larus-breeze/hw_sensor/README.md

# PCB design for Larus Sensor 

## Facts
- STM32F407 for signal processing 
- U-Blocks M9N GNSS
- xSense MTi1 IMU
- MS5611 static pressure sensing
- HSCMRRV001PG2A3 pitot pressure sensing
- Micro-SD for logging
- ESP32 for Bluetooth and Wifi Connectivity
- CAN Bus via RJ45
- RS232 via RJ45
- USB connectors for STM32, ESP32, GNSS

## Assembled sensor V2.0

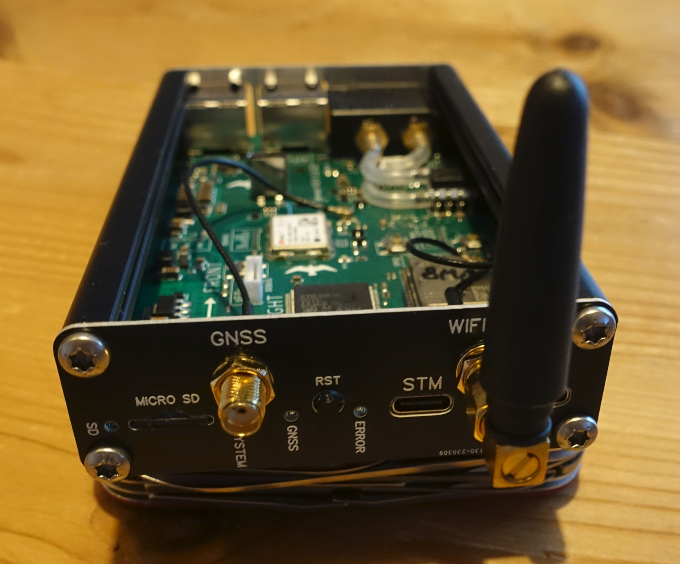
[picture p1: media/v2_full_assembled_front.jpg]


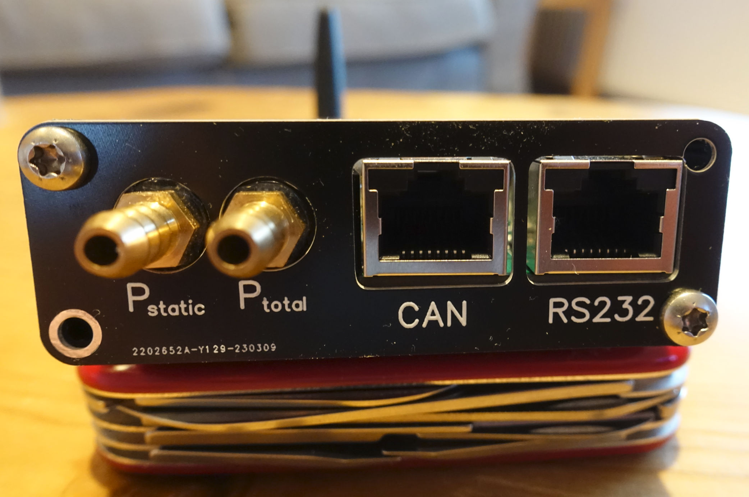
[picture p2: media/v2_full_assembled_back.jpg]


## PCB design V2.0

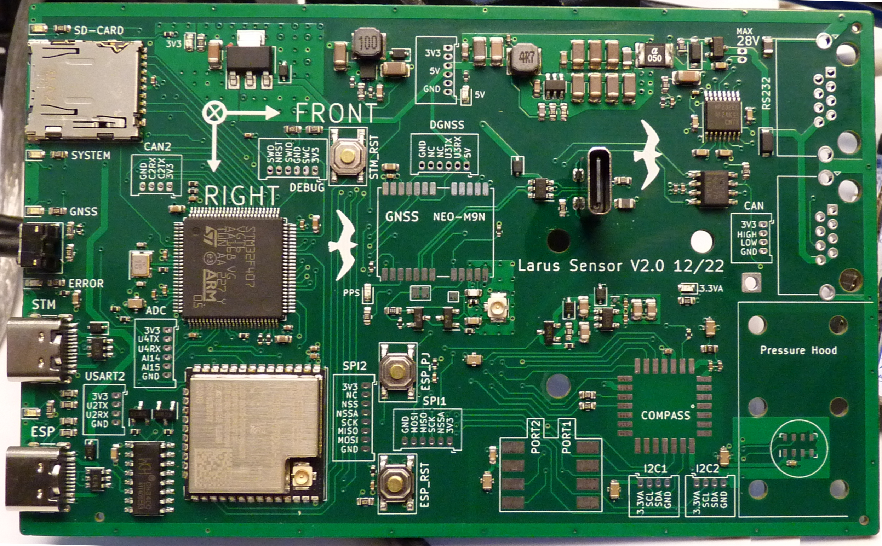
[picture p3: media/v2_soldered_components.jpg]
Components Soldered Model


## Assembled sensor V1.0
Static and pitot pressure shall be connected using 5mm inner diameter houses which are typical in a glider

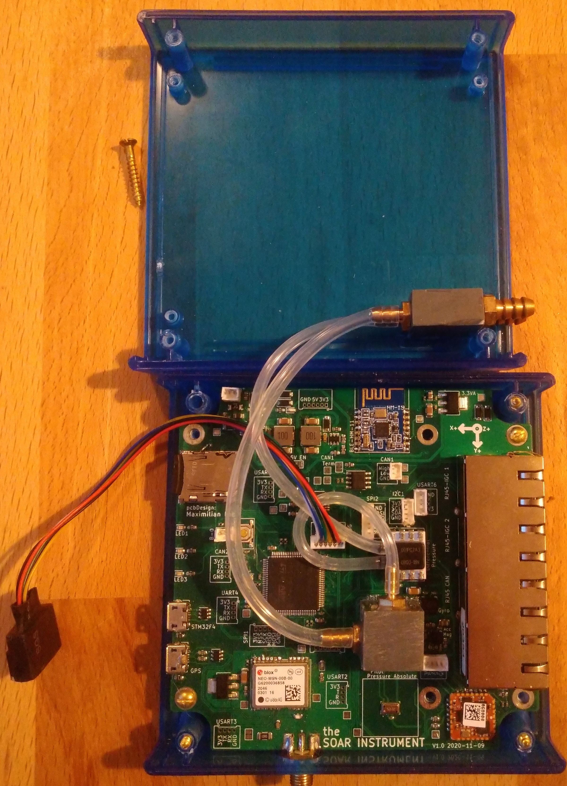
[picture p4: media/v1_full_assembled_1.jpg]
Assembled 1


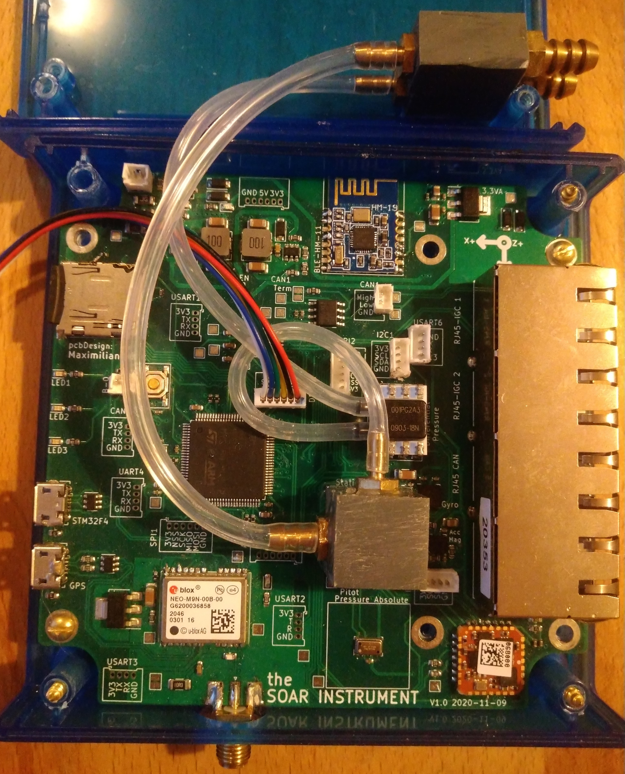
[picture p5: media/v1_full_assembled_2.jpg]
Assembled 2


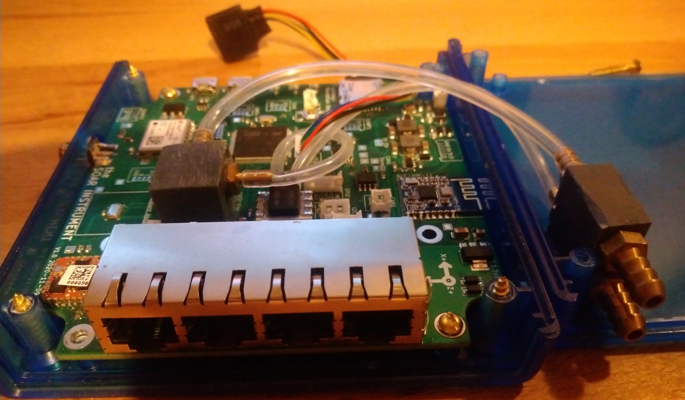
[picture p6: media/v1_full_assembled_3.jpg]
Assembled 3
