larus-breeze/hw_sensor/design/README.md

# PCB design for Sensor V2.0 

## Current consumption consideration
### Measured consumption of hw version 1.0
- M9N GNSS active, SD-card logging active, Bluetooth connected, 
- 1.071W 85mA Peak at 12.6V supply. ~ 320mA at 3.3V
- 50mA HM-19 Bluetooth

### Maximum estimation 3.3V Line for hw version 2.0
- 102mA max @85°C STM32F407 
- 200mA max peak Micro SD
- 100mA peak max M9N GNSS
- 130 - 310mA ESP32 (70mA CPU + 240mA Wifi full power or 60mA bluetooth connected) 
- 33mA xSense MTi1 IMU
- 1.4mA peak MS5611
- 2.8mA peak HSCMRRV001PG2A3 absolute pressure sensing
- 1mA (60mA short circuit output current) RS232 Converter
- 60mA "Dominant- High Bus Load"  180mA "Dominant- Bus Fault" CAN Transceiver
Total:  810.2mA max total. 

## Mechanical design:

### Enclosure
- Hammond Electronics 1455K1202 Enclosure 75x 120mm  PCB 74.6 x 120
- Free Space (active area on PCB) in enclosure 70 x 120  with some margin 69 x 120 mm 

### PVC milled 5mm Hose preassure connector
- 30mm(long) x 20mm(wide) x ~ 15 .. 20mm( high) 
- 1 x MS5611 underneath 
- 6 x 2.5mm screw connection to PCB. 

## ESP32 for WIfi / BT connectivity
- GPIO16 / GPIO17 on ESP32 connected with USART2 (PA2/PA3) at 38400 baud. Flashed https://github.com/AlphaLima/ESP32-Serial-Bridge   Prototype works. Connection of two Android Smartphones with each two connenctions to a TCP socket worked. 
- Connect GPIO04 / GPIO15 on ESP with USART1 (PA9/PA10), Connect STM32F4 Reset and Boot0. 
- Add some headers for the other esp32 connectors.
- Add a reset and program (GPIO0) button. Connect GPIO1/GPIO3 via CH340E to a USB connector.
- Connect a SPI data pump between ESP(Slave VSPI) and STM32(Master SPI2).  
Use ESP Pins: VSPI (CS:  5, CLK: 18, MOSI: 23, MISO: 19)  https://github.com/hideakitai/ESP32DMASPI  
Use STM32 Pins: CS: PB12, CLK: PB13, MOSI: PB15, MISO: PB14 ( Reuse L3GD20 interface, but provide another CS on the connector (PB0 or PB1) in case an external IMU needs SPI2)

- Where to connect the external RS232 interfaces?  XCSOAR via Wifi should be able to put data on the external RS232 line.  
- Should an external device be able to talk to the STM32F4 directly or is it sufficient to connect these inputs only to the ESP32?
- STM32F4 RS232: USART1, USART2   
- STM32F4 BT: USART6

ESP32 Pins
USART0:  GPIO1, GPIO3   (Debug & Flash UART)
USART1:  GPIO15(RX), GPIO04(TX)
USART2:  GPIO16(RX), GPIO17(TX)   (Tested ok)
VSPI CS: GPIO5
VSPI CLK: GPIO18
VSPI MOSI: GPIO23 
VSPI MISO: GPIO19
