larus-breeze/hw_sensor/design/datasheets/analog supply/NFM18PS105R0J3.png

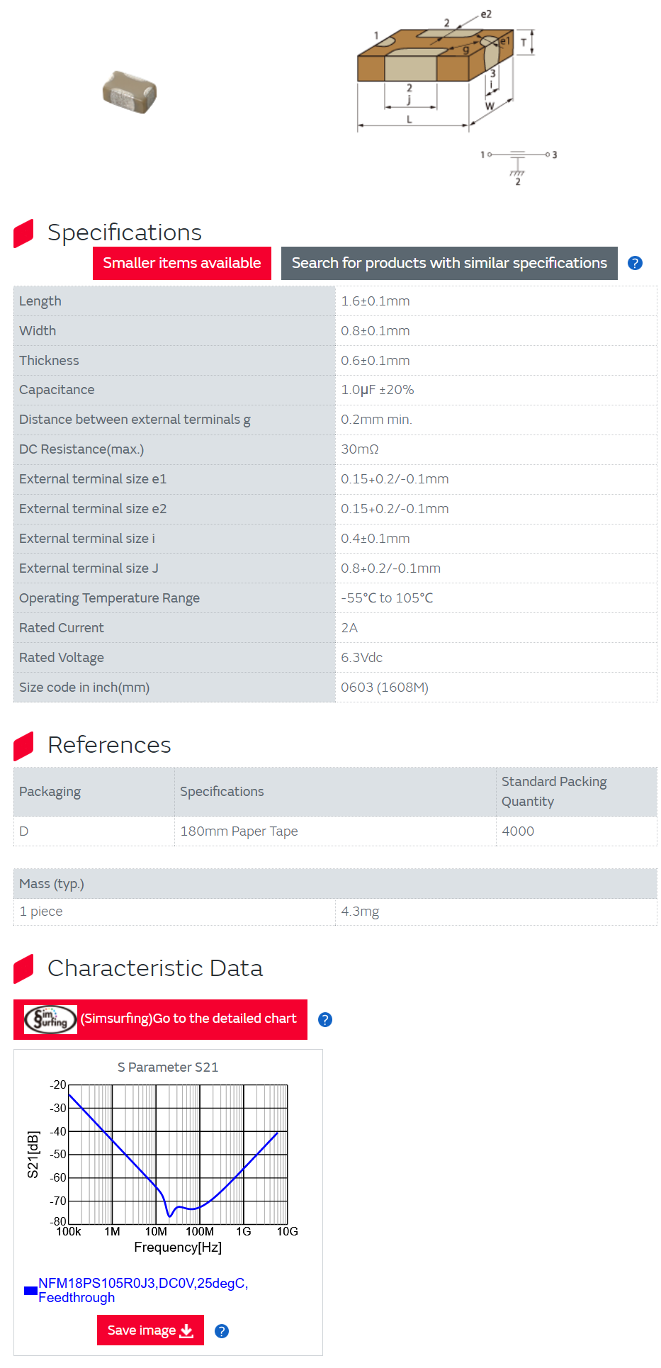
design/datasheets/analog supply/NFM18PS105R0J3.png
