larus-breeze/hw_sensor/media/v1_3DModel.png

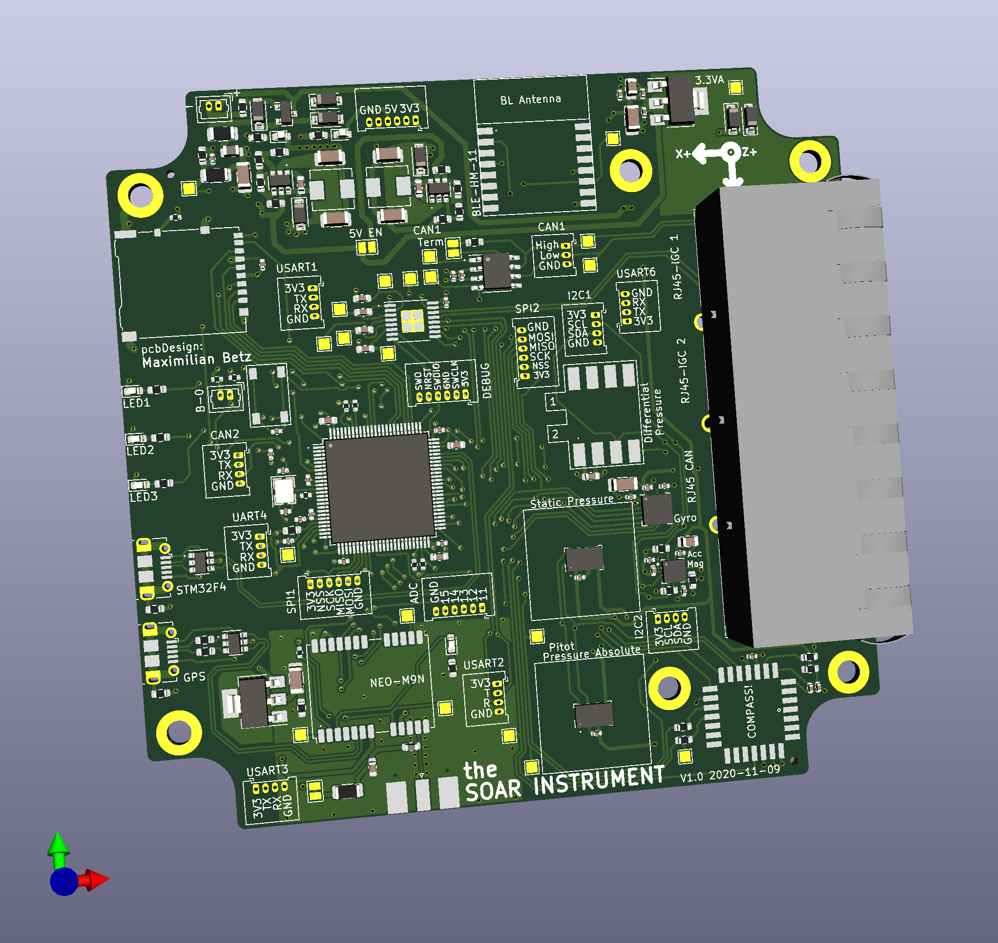
media/v1_3DModel.png
