larus-breeze/hw_sensor/design/pressure-hood/hood.FCStd

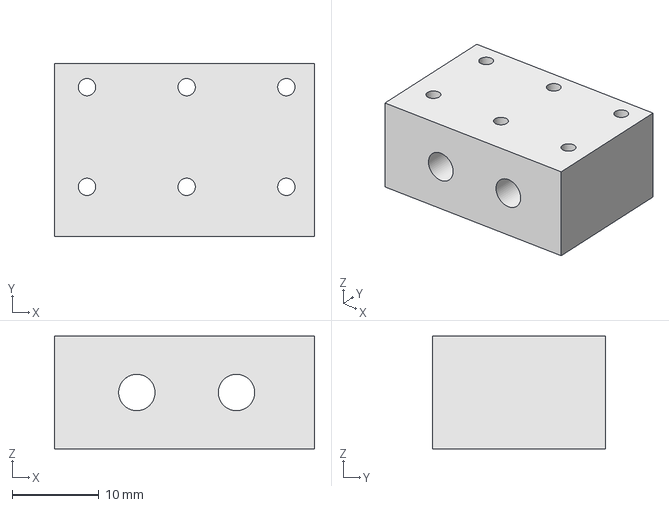
[picture p9: CAD file, 2024-06-01]
design/pressure-hood/hood.FCStd
30.0 x 20.0 x 13.0 mm
