larus-breeze/hw_sensor/(list of files, cad)

Other CAD files:
parts/barb_adapter.FCStd
design/pressure-hood/hood.stl
