larus-breeze/hw_sensor/design/uart_bluetooth_rs232_wiring_concept.png

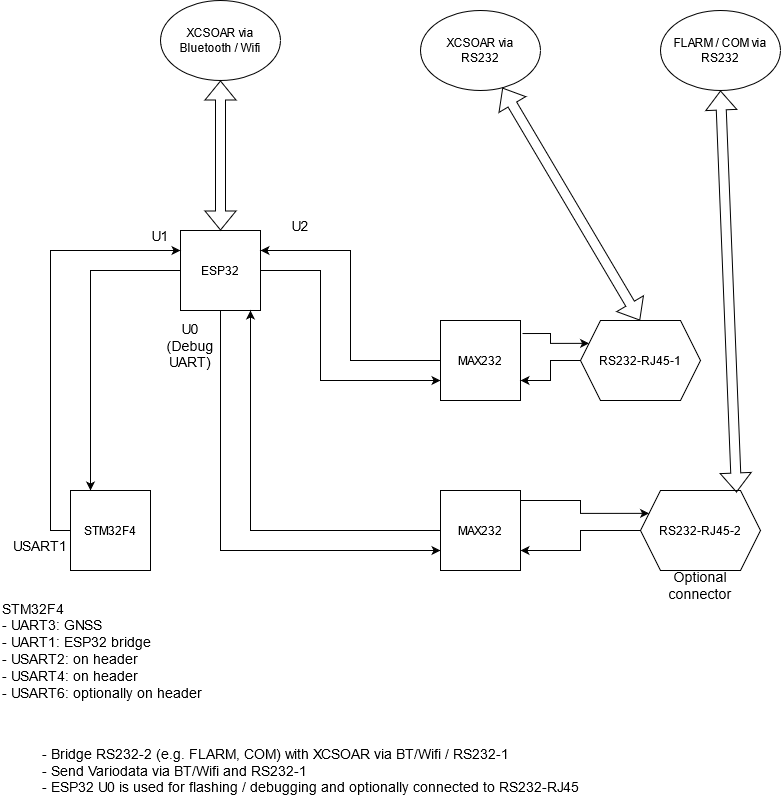
design/uart_bluetooth_rs232_wiring_concept.png
