larus-breeze/hw_sensor/media/v1_soldered_components.jpg

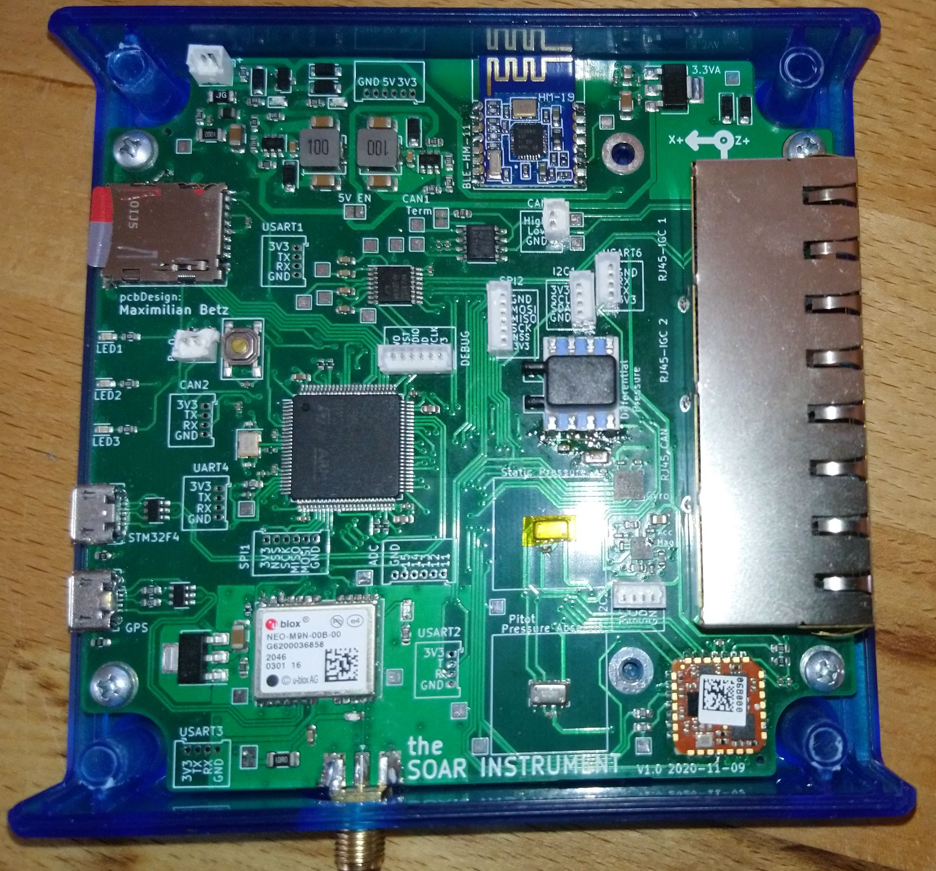
media/v1_soldered_components.jpg
