larus-breeze/hw_sensor/(threads)

Thread 1 (2022-02-25):

MagSensor Position

degeflija, 2022-02-25:
Max, kannst du den MagSensor aus der Ecke rausholen und ein wenig besser und freier einbauen ?
Ich vermute, dass das RJ45 Gehäuse da ein wenig abschirmt.

Außerdem sollten wir sicherstellen, dass alle Gehäuseschrauben aus Messing sind.

Thread 3 (2023-01-20):

USB Booster Supplies RJ45 with 13.2V

MaxBaex, 2023-01-20:
The USB -> 13.2V DC-DC booster power is available at the RJ45 socket. The booster will supply the entire panel supply via USB. There is a booster over current protection but not more!  Thus there shall be a proper isolation between the USB and RJ45 supplies.

MaxBaex, 2023-04-28:
Do not connect a USB cable and a 12V Power Supply via RJ45 at the same time.   Workaround could be to remove the 3 USB supply diodes and supply the hardware only via the RJ45 connector.

The input voltage MOSFET reverse voltage protection shall be replaced with a simple diode in order to allow connecting both supplies, USB and RJ45 simultaneously.

MaxBaex, 2025-02-23:
It is a feature not so, won't be fixed.

Closed 2025-02-23.

Thread 4 (2023-01-29):

GND Plane unter Solderjumpers ausblitzen, Solder jumpers überarbeiten

floriangaller, 2023-01-29:
Unterhalb der verbundenen Solderjumpers sollte man die GND/VCC plane ausblitzen. Beim auftrennen kann man das Laminat beschädigen und damit potenziell eine Kurzschluss machen.

Weiters sind die Verbindungen zwischen den Pads deutlich breiter als die restlichen Leitungen. Warum?

Weiters sollten wir für die alte CAN Stecker Belegung Vorkehrungen treffen, dass man keine Jumperwires benötigt.

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

Closed 2024-01-06.

Thread 5 (2023-02-14):

Anschlüsse

MaxBaex, 2023-02-14:
Die RJ45 Buchsen stehen zu nahe am Rand für das schmale Gehäuse 1455J1201.  Es ist mit diesem Gehäuse auch kein Platz für SMA Buchsen auf der Rückseite.

MaxBaex, 2023-02-18:
Steckeralternativen evaluieren:  ix Industrial     kleiner RJ45 Nachfolger.  Mouser: https://www.mouser.de/ProductDetail/HARTING/09452812560?qs=lc2O%252BfHJPVb7MWmafU5g%252Bw%3D%3D

floriangaller, 2023-02-20:
> Steckeralternativen evaluieren:  ix Industrial     kleiner RJ45 Nachfolger.  Mouser: https://www.mouser.de/ProductDetail/HARTING/09452812560?qs=lc2O%252BfHJPVb7MWmafU5g%252Bw%3D%3D
>
> Alternativ auf einen RJ45 Anschluss reduzieren und RS232 /  CAN beides auf diesem zur Verfügung stellen.  Gibt es Use-Cases für mehr als einen RS232 Anschluss?

Das würde ich nicht machen... RJ45 ist standard für Serial NMEA Verbindungen in Segelfliegern, leicht erhältlich, veriegelt,...

Was man IMHO überlegen kann...
 Es gibt low proflie RJ45 die könnten das Höhenproblem lösen
 Den CAN könnte man auf einen anderen Stecker legen.

Der Nachteil an den RJ45 ist eigentlich,dass sie halt nicht sauber spezifiziert sind... Vorallem im Bezug auf Kabelbrand... man sollte halt in einem Cockpit nix verbauen was von selbst weiterbrennt und eigentlich auch nix was übermäßig Rauch eintwickelt... (GFK/CFK ist da vermutlich ausgenommenn :-))

Wenn man in Richtung Luftfahrt konformer Stecker gehen will, dann kann man sich die MIL Stecker von Amphenol ansehen... Aber die sind auch relativ groß und teuer... aber machen beim Anstecken einen sehr wertigen eindruck.

Aber ich denke nicht das uns der standard Segelflieger dankbar ist wenn wir für uns den Standard ändern...

floriangaller, 2023-02-20:
> Alternativ auf einen RJ45 Anschluss reduzieren und RS232 /  CAN beides auf diesem zur Verfügung stellen.  Gibt es Use-Cases für mehr als einen RS232 Anschluss?

Ich denke schon, dass es dafür use cases gibt:

Eigentlich hat man ja fast nie genug Serielle im Flieger...
XPDR will ein GPS mit komischer Baudrate manchmal auch komischen Format
ELT will GPS mit komischer Baudrate
Funk kann man fernsteuern
IGC Höhe aus dem Logger, Task programmieren, igc file auslesen...
Vergleich mit anderem Vario und daher Aufzeichnung des NEMA Streams...
Anschluss xc vario und openvario

Bei CAN bin ich leider eher blank aber da kann ich mir auch eine Vielzahl an Sensoren vorstellen:
Wölbklappen, Abgriff der Steuerung, Temperatur, Sonneneinstrahlung, TEK Druck, Fahrwerk, Knüppel, Bremsklappe, ...

Ich sehe das Ganze schon eher als Plattform auf der dann weitere Entwicklungen aufgesetzt wereen können, und da hat man halt meist zu wenige Interfaces... Vlt brauchts da zwei Versionen, wobei das macht halt leider auch alles wieder sehr aufwändig...
Oder Steckerbelegung über Bestückungsänderumg... aber das ist halt wieder super gefährlich mit unbedarften Benutzern

MaxBaex, 2023-02-20:
Ich denke auch, das wir keinen neuen Standard für die "seriellen" Anschlüsse erfinden sollten. Hier ist RJ45 einfach ein bewährter Standard. Denkbar wäre anstelle des CAN-RJ45 ein kleinerer 4 poliger Stecker, für Spannung und CAN. Der CAN-RJ45 kann aktuell in einen seriellen RJ45 umgewandelt werden. Das Feature sollte denke ich bestehen bleiben.

Vielleicht passen 2 SMA Anschlüsse mit eng gepackten RJ45 Low-Profilen (z.B. RJE051880310) und einem evtl. etwas geschrumpften Druckanschluss noch in das Gehäuse.

floriangaller, 2023-02-20:
> Ich denke auch, das wir keinen neuen Standard für die "seriellen" Anschlüsse erfinden sollten. Hier ist RJ45 einfach ein bewährter Standard. Denkbar wäre anstelle des CAN-RJ45 ein kleinerer 4 poliger Stecker, für Spannung und CAN. Der CAN-RJ45 kann aktuell in einen seriellen RJ45 umgewandelt werden. Das Feature sollte denke ich bestehen bleiben.

Viel schmälere Stecker zu finden wird vermutlich schwierig.

Ix wäre okay, sonst könnte man auch noch einen M8 nehmen. Z.B. Amphenol M8AS-04PMMR-SF8001. Aber ob man da wirklich platz spart muss man sich genau ansehen, denn die stecker haben ja auch einen mindestabstand damit man mit den Kabeln kein Problem bekommt... da hilft es ungemein das ganze voher in ein Cad zu werfen. Ich befürchte viel kleiner als rj45 sind dann beide nicht.

MaxBaex, 2025-01-01:
Wir werden bis auf weiteres bei RJ45 bleiben, daher schließe ich dieses Ticket.

Closed 2025-01-01.

Thread 12 (2023-12-18):

CAN 120Ohm Jumper

MaxBaex, 2023-12-18:
which is easily configurable through the user without soldering or opening the enclosure.

MaxBaex, 2024-03-10:
added a dip switch.  Opening the enclosure is required to opperate it as there is not enough space on the pcb edge to put a switch there.

Closed 2024-03-10.

Thread 15 (2024-04-25):

Wanted: pressure block design files

roeles, 2024-04-25:
I'm looking for the pressure sensor cover block and the block where the brass inserts for the pressure tubes are inserted.
Can you please share the design files?

MaxBaex, 2024-06-01:
Pressure hood is added here: https://github.com/larus-breeze/hw_sensor/tree/master/design/pressure-hood
The holes need M5 threads for the brass pressure connectors.

Closed 2024-06-01.

Thread 16 (2024-06-01):

Move CAN termination switch

MaxBaex, 2024-06-01:
I would be ideal if the CAN termination switch could be switched without opening the enclosure.
Especially in case the enclosure is sealed. E.g. move it to the edge.

MaxBaex, 2025-01-01:
This Switch could be an alternative: K3-1296S-E2  Placed on the backside below the Pressure Hood. (Would be the only part on the backside. Increases Manufacturing complexity)

Closed 2025-02-23.

Thread 18 (2024-06-26):

MTi-1 HW V5

henrik-the, 2024-06-26:
Hi,

did anybody already test the HW V5 of the MTi-1 Module? Is it compatible with the current software?
https://www.mouser.de/ProductDetail/Movella-Xsens/MTi-1-5A-T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

The Migration Guide tells, that it should be compatible:
https://base.movella.com/s/article/Migration-to-Hardware-Version-5-of-the-MTi-1-series?language=en_US

Laca81, 2024-11-02:
I just built one with MTi-1-5A-T and it works fine. This is my first Larus build so I don't know how it works with the previous version of this IMU.

realtimepeople, 2024-11-03:
Hi guys, great to hear that your have managed to build a Larus on your own.
I would be very much interested in some *.f37 log files from your sensors to check if the new IMU version is more precise than the old ones. Can you please contact me via the official larus mail larus@e.mail.de ?

henrik-the, 2024-11-28:
Hi,
I have build my Larus with the "old" IMU. So i think I can't help.

invrtd, 2025-03-20:
@realtimepeople Did you get any of the wanted files? If not I would not mind sending some after I get mine built with the newer IMU.

realtimepeople, 2025-03-21:
No, up to now I did not get any log files with the new IMU.

Laca81, 2025-03-21:
I am totally sure that I sent you a log. Should I resend it or a new one?

realtimepeople, 2025-03-21:
Oh, sorry.
Yes, I have seen one of your short logs some time ago.

It would be interesting to see several minutes of a log file,
measured on ground, while circling and flying straight.

Closed 2025-02-23.

Thread 27 (2025-02-25):

Release 2.2 BOM and CPL

invrtd, 2025-02-25:
I've been planning on building my own Larus for a bit now and the new release has gotten me moving on the project again and I've noticed a few issues.

Problems I can fix myself but need to be fixed in the release,
- SW2, U6, J4 and J5 have incorrect translation
- U3, U14, U15, U16 and U17 have incorrect rotation
- The positions for RJ-45 j3 and j8 have incorrect rotation and translation.
- BOM says MS5611-01BA for U7 while kicad has MS5611-01BA03 as the Mfr. No
- This is a nit the capacitors for C37 and C60 are out of stock and substituted with  LCSC# C913910

And I could find parts that are close but I want to make sure my substitutes should be okay
- The blue LEDs are out of stock with no equivalent so LCSC# C125103 seems close enough with lower wattage
- The HSCMRRV001PG2A3 is EOL and seems to be a 1:1 replacement HSCMRRV001PD2A3 ???

MaxBaex, 2025-02-25:
- any blue LED in a 0603 package should do.  You might want to adjust the series resistor depending on the desired current.
- HSCMRRV001P**D**2A3 won't work as it is a +- differential, instead of a gauge version. Choosing this one would half the resolution and requires firmware changes. We do not recommend this.
- If changing capacitors make sure you chose the same voltage rating, value and type(e.g. 16V 100nF **X7R**)
- I might fix incorrect translation or rotations in a future release
- MS561101BA03-50 is the correct one

invrtd, 2025-02-25:
Do you have any recommendations on sourcing the HSCMRRV001PG2A3? I am having a hard time finding a source to purchase in small quantities.

MaxBaex, 2025-02-28:
Mouser states HSCMRRV001PG2A3  as EOL.  Farnel and RS-online does not. Currently we do not see the need for changing this component.

Closed 2025-02-28.
