larus-breeze/hw_sensor/media/v2.0_schematic.pdf

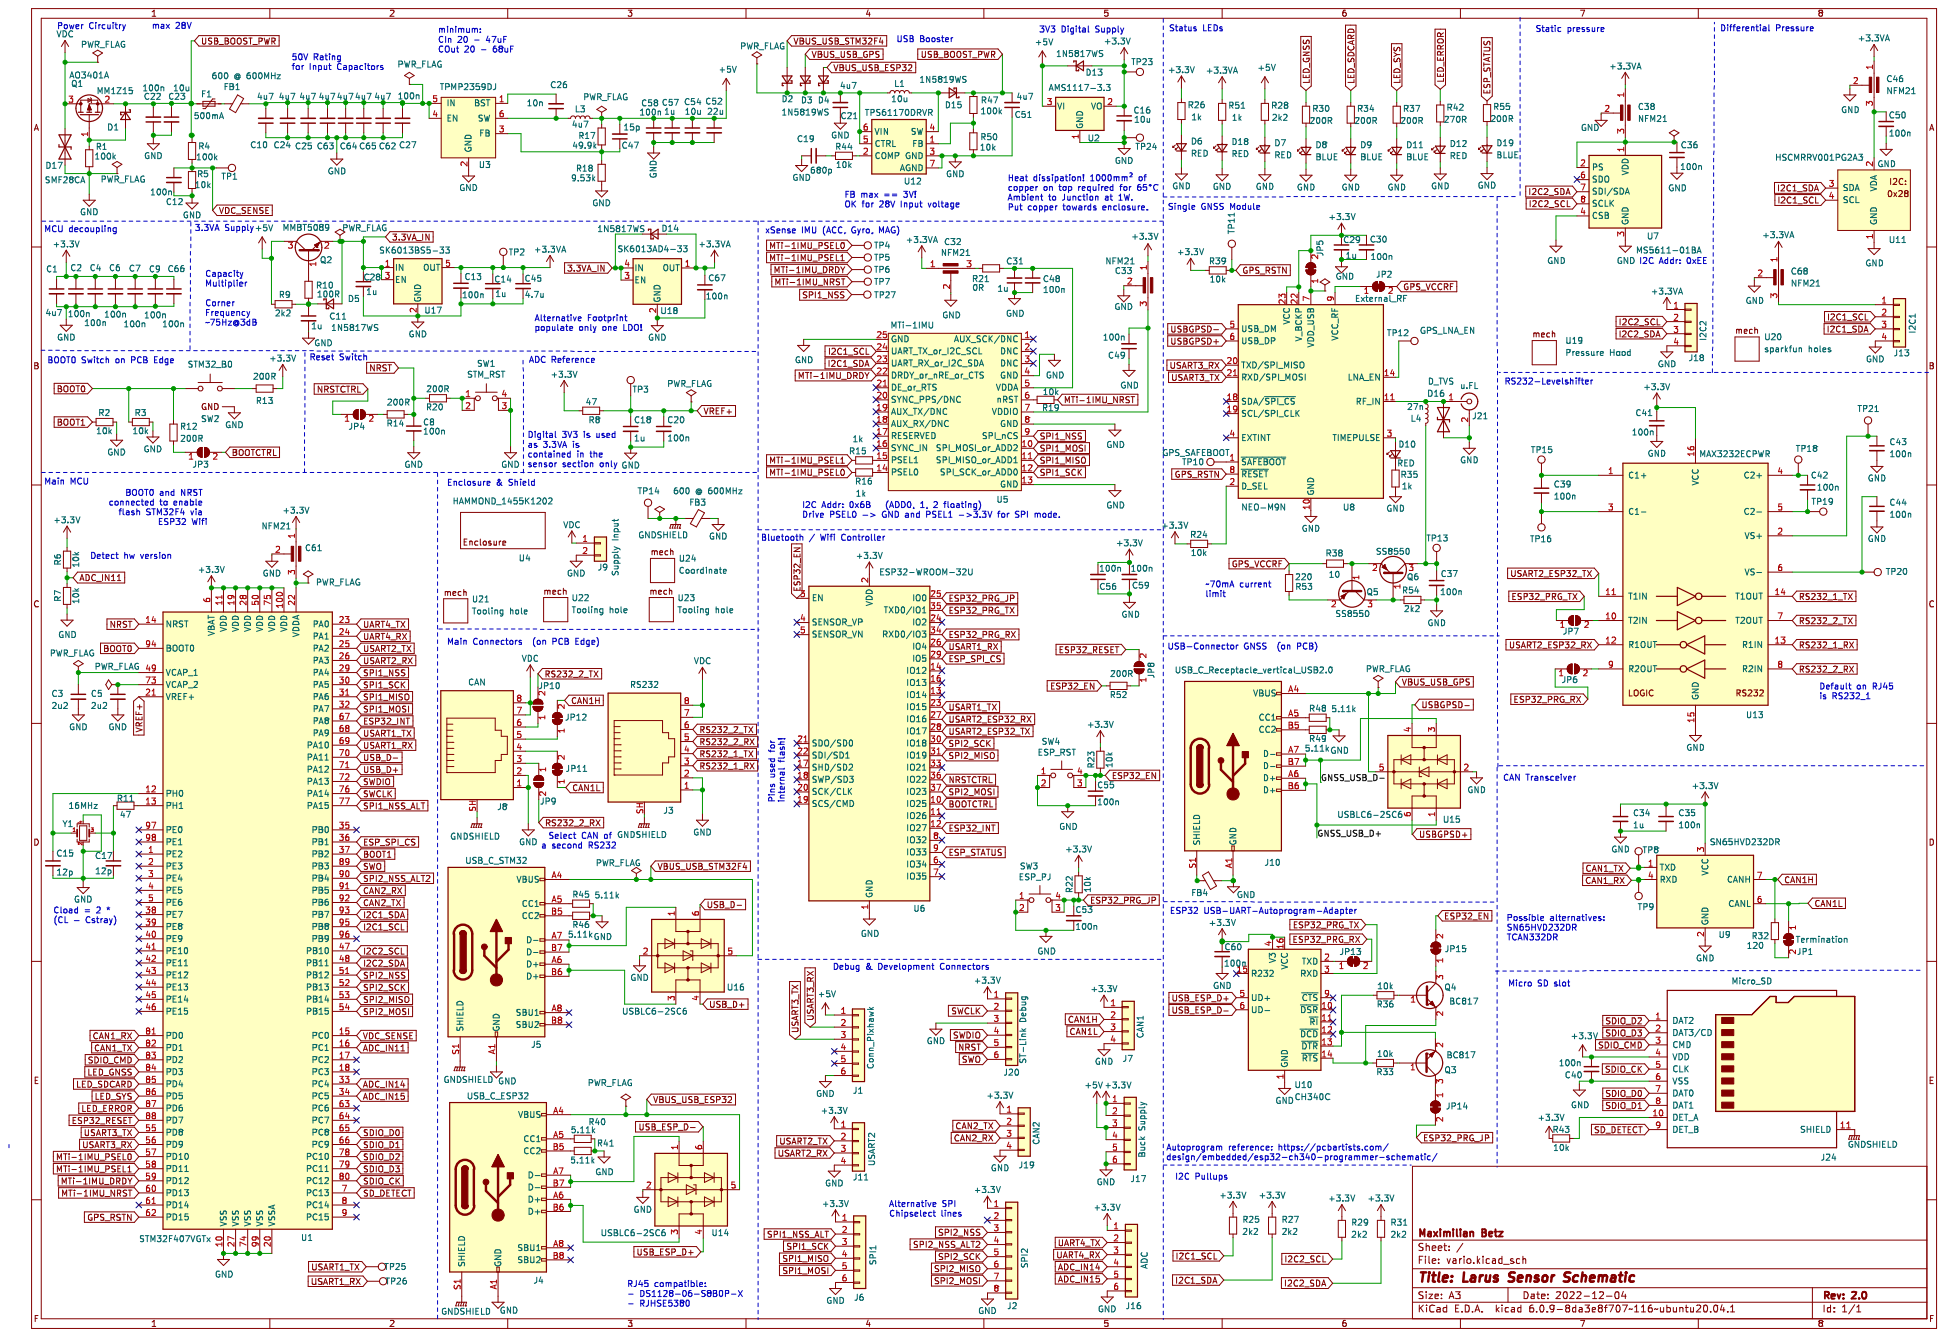
[picture p12: page 1]
