larus-breeze/hw_sensor/media/v1.0_schematic.pdf

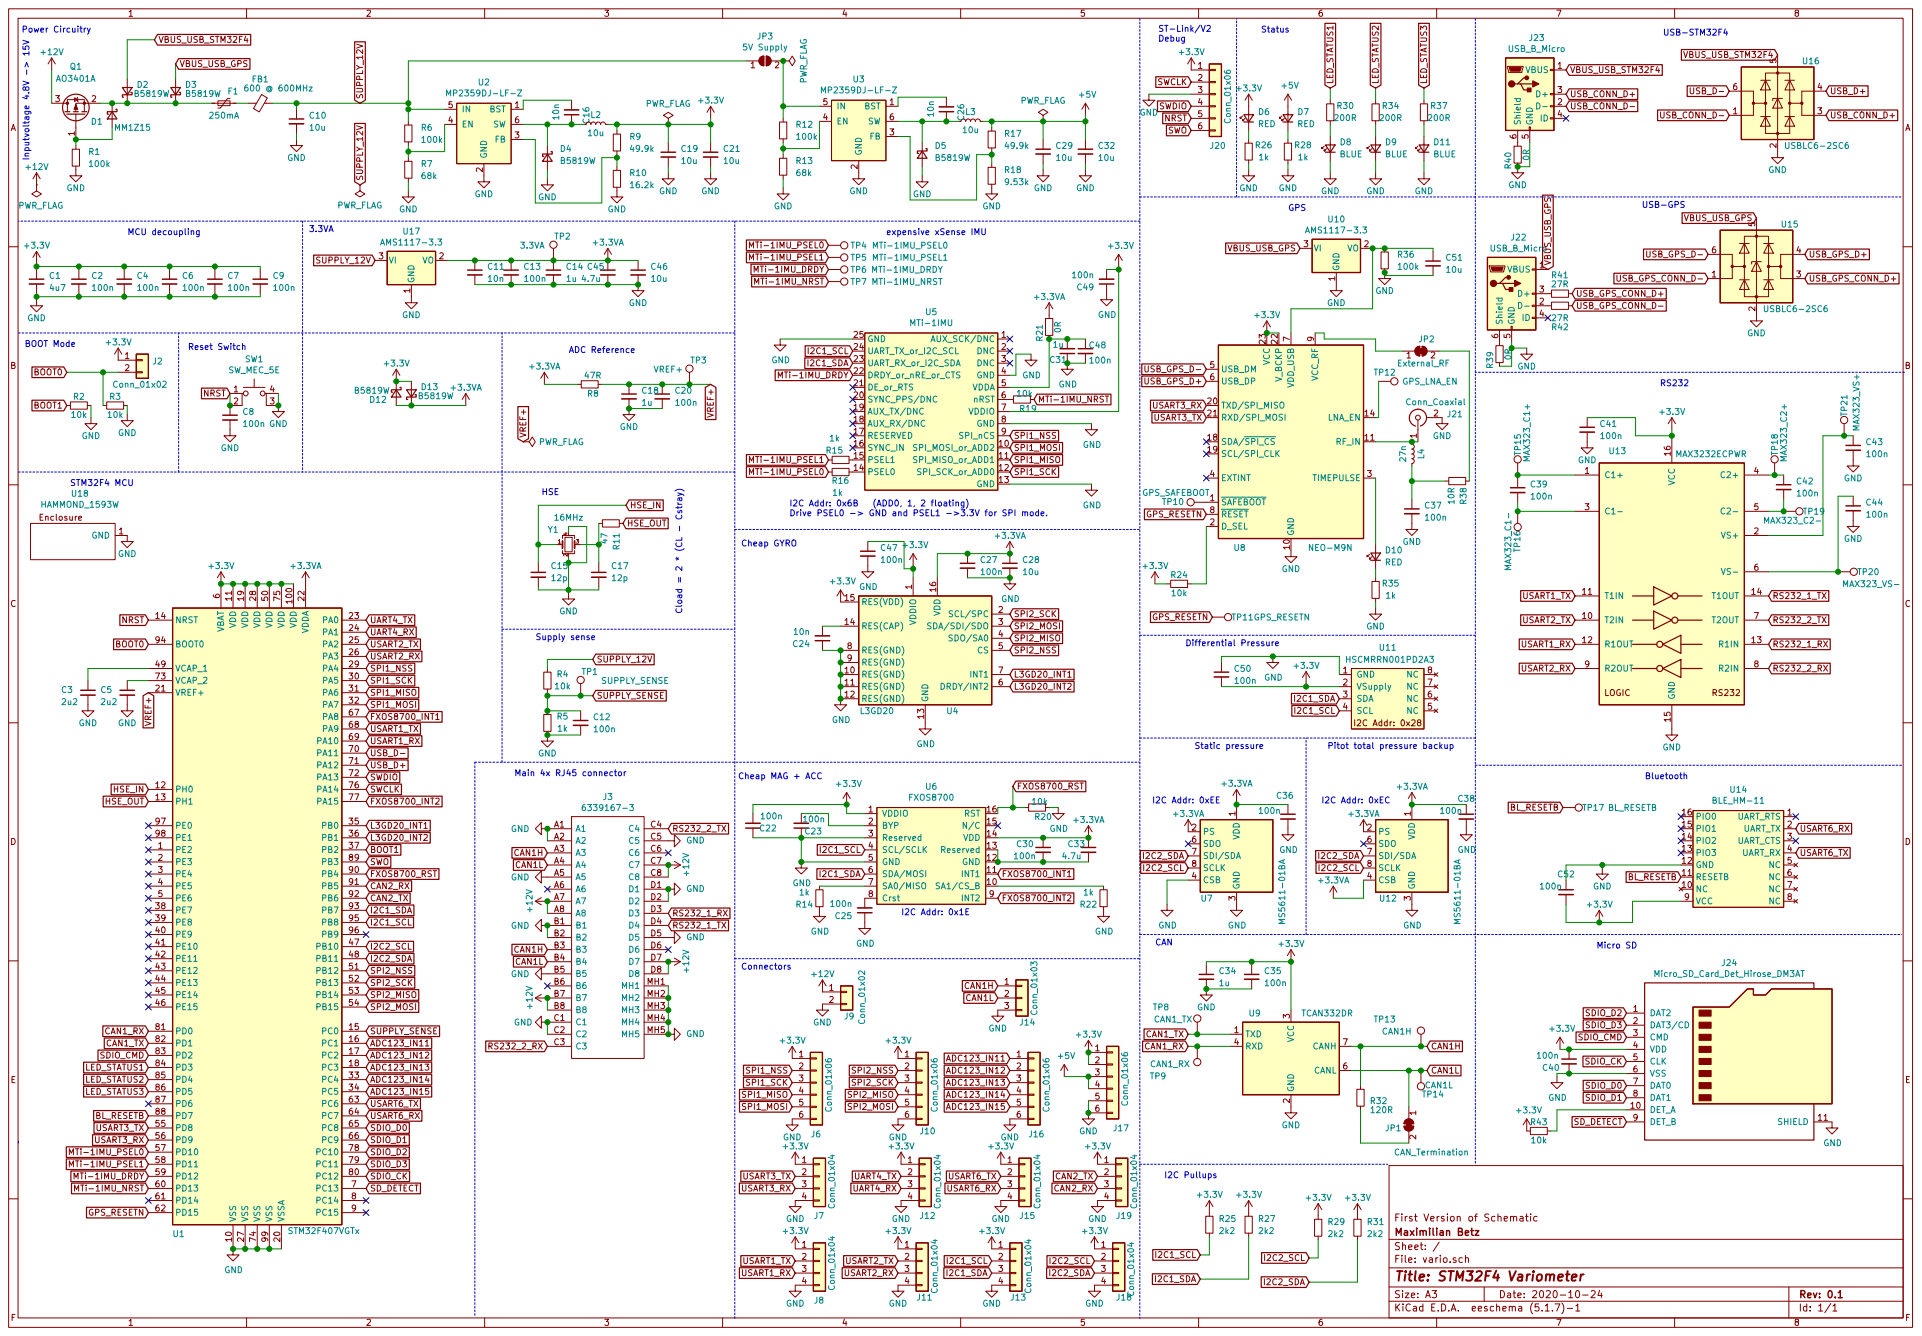
[picture p13: page 1]

expensive xSense IMU Inputvoltage 4.8V -> 15V

Static pressure Reset Switch
I2C1_SDA NRST

I2C Addr: 0x1E Cload = 2 * (CL - Cstray)

1 RES(GND) 10 RES(GND) 11 RES(GND) 12 GND 13

6 VCAP_1 49 VCAP_2 73 VDD 100 VDD 11 VDD 19 VDD 28 VDD 50 VDD 75 VDDA 22 VREF+ 21 VSS 10 VSS 27 VSS 74 VSS 99 VSSA 20U1 STM32F407VGTx +3.3VR43

3 CSB 4 SDO 6 SDI/SDA 7 SCLK 8 U7 MS5611-01BA

3 CSB 4 SDO 6 SDI/SDA 7 SCLK 8 U12 MS5611-01BA

Id: 1/1 Title: STM32F4 Variometer File: vario.sch Sheet: / Maximilian Betz First Version of Schematic
