larus-breeze/hw_sensor/(commit log)

2020-11-13 Initial import of ordered version.
    [vario-B_Cu.gbr, vario-B_Mask.gbr, vario-B_Paste.gbr, vario-B_SilkS.gbr, vario-Edge_Cuts.gbr, vario-F_Cu.gbr, vario-F_Mask.gbr, vario-F_Paste.gbr]
2020-11-25 added latest Schematic file.
    [vario.sch]
2020-12-01 readded disapeared XSENSE IMU to schematic.
    [vario.sch]
2020-12-07 corrected wrong I2C addresses MS5611 in schematic.
    [vario.sch]
2020-12-09 again corrected a still wrong i2c address.
    [vario.sch]
2021-03-21 hint to update the mechanical pressure connections
2021-03-25 moved kicad files to pcb. To prepare for additional cad parts
    [vario-B_Cu.gbr, vario-B_Mask.gbr, vario-B_Paste.gbr, vario-B_SilkS.gbr, vario-Edge_Cuts.gbr, vario-F_Cu.gbr, vario-F_Mask.gbr, vario-F_Paste.gbr]
2021-03-25 threading done
2021-03-25 beatified and created stl file
    [barb_adapter.stl]
2021-03-26 added printed parts
2021-03-28 added a second version of barb adapter.
    [barb_adapter.stl, barb_adapter_v1.stl, barb_adapter_v2.FCStd, barb_adapter_v2.stl]
2021-10-14 add hint for power supply voltage sense filtering
2022-02-01 updated readme and added some latest pictures
    [barb_adapter_v1.stl, barb_adapter_v2.FCStd, barb_adapter_v2.stl]
2022-02-01 removed old pictures and pdf schematics
2022-02-01 cleaned up todos in pcb README.md for next hardware version
2022-04-08 updated files for new kicad version
    [vario.kicad_pcb]
2022-07-04 added two more enclosure options as an idea
2022-07-04 add link to nice debug connector / footprint
2022-07-30 planned esp32 integration
2022-07-31 added uart bluetooth rs232 wiring concept for next hw version
    [PreassurePart.FCStd]
2022-07-31 updated milled preassure connector design
    [PreassurePart.FCStd]
2022-07-31 updated schematic. Removed 2nd ms5611, changed enclosure, removed cheap imu sensors
    [vario.kicad_sch]
2022-07-31 changed to usb-c connectors in schematic
    [vario.kicad_sch]
2022-07-31 connected a SPI pump between ESP32 and STM32
    [vario.kicad_sch]
2022-07-31 updated dc-dc power supply and added enough capacity
    [vario.kicad_sch]
2022-07-31 dc-dc output filtering
    [vario.kicad_sch]
2022-08-01 added switch order-code for boot0
2022-08-07 added boot 0 pushbutton
    [vario.kicad_sch]
2022-08-07 updatet schematic
    [vario.kicad_sch]
2022-08-07 connected 3.3VA to 5V Buck output for higher possible input voltage.
    [vario.kicad_sch]
2022-08-07 rearranged some components
    [vario.kicad_sch]
2022-09-17 updated schematic according to readme.md and added usb-c footprint.
    [vario.kicad_sch]
2022-09-17 updated 3.3VA supply filtering
    [vario.kicad_sch]
2022-09-17 minor updates cleanups
    [vario.kicad_sch]
2022-09-17 added some more connections between stm32 and esp32
    [vario.kicad_sch]
2022-09-19 added program jumper and reset for esp32. removed some connectors and addes testpoints instead
    [vario.kicad_sch]
2022-09-19 added a second cs line to spi2 connector
    [vario.kicad_sch]
2022-09-24 updated schematic:u.fl for GNSS, 2 x single RJ45, resolved all warnings and errors
    [vario.kicad_sch]
2022-09-24 added some missing footprints and partnumbers
    [vario.kicad_sch]
2022-09-24 replaced CAN transceiver with an alternative, optimized readability of schematic
    [vario.kicad_sch]
2022-09-24 changed 1M resistor footprints
    [vario.kicad_sch]
2022-09-24 improved component naming for layout
    [vario.kicad_sch]
2022-09-24 updated component name for layout
    [vario.kicad_sch]
2022-09-24 updated component names for layout
    [vario.kicad_sch]
2022-09-24 started new pcb with part placement
    [vario.kicad_pcb]
2022-10-01 updated pcb/README.md with new todos and cleaned up
    [vario.kicad_pcb]
2022-10-01 Connected differential pressure supply to analog voltage and beautified schematic symbol
    [vario.kicad_sch]
2022-10-01 connected shield gnds to enclosure and with ferrit to gnd
    [vario.kicad_sch]
2022-10-01 changed +12V symbol to VDC symbol, as 12V was missleading
    [vario.kicad_sch]
2022-10-01 changed input filtering for buck converter
    [vario.kicad_sch]
2022-10-01 esd protection for esp32 usb added, adjustes 5v led resistor, added closed solder jumper on CH340 TXD pin
    [vario.kicad_sch]
2022-10-04 removed the 3.3V buck converter and added the 3V3 digital LDO. 3.3VA LDO and filter missing
    [vario.kicad_pcb, vario.kicad_sch]
2022-10-04 rearranged some schematic components
    [vario.kicad_sch]
2022-10-04 schematic beautification
    [vario.kicad_sch]
2022-10-04 changed ldo for a GNSS to a less oversized one
    [vario.kicad_sch]
2022-10-04 prepared analog 3.3V supply, improved readability by removing redundant text from schematic
    [vario.kicad_sch]
2022-10-04 added some TODO hints to the schematic.
    [vario.kicad_sch]
2022-10-05 updated TODOs, with an idea to allow supply through USB.
    [vario.kicad_sch]
2022-10-15 1st Version of powersupply considerations, including also datasheets of the used components
2022-10-15 Update powersupply.md
    Added TODO for the digital LDO:
    powerdisipation could be a problem there
2022-10-15 Update powersupply.md
    added 100 Ohm for stability
2022-10-16 added capacity multyplier for 3.3VA LDO input
    [vario.kicad_sch]
2022-10-18 added feedthrough capacitors for analog components
    [vario.kicad_sch]
2022-10-18 updated TODOs in Readme
    [vario.kicad_sch]
2022-10-20 removed separate GNSS LDO after tesing feasability on first hardware version, updated straight usb connector schematic symbol,
    [vario.kicad_sch]
2022-11-03 added comments during review
    [vario.kicad_sch]
2022-11-08 add esp32 autoprogram circuit, added some discharge diodes, attached RS2322 to RJ45
    [vario.kicad_sch]
2022-11-08 some cleanup
    [vario.kicad_sch]
2022-11-09 replaced CH340E with CH340C for the ESP32 autoprogramming feauture
    [vario.kicad_sch]
2022-11-09 updated layout from schematic
    [vario.kicad_pcb, vario.kicad_sch]
2022-11-09 positioning parts on pcb started
    [vario.kicad_pcb, vario.kicad_sch]
2022-11-10 updated manufacturing capabilities, default trace width and usb differential pair properties
    [vario.kicad_pcb]
2022-11-10 moved footprint references from silkscreen to fabrication layer
    [vario.kicad_pcb]
2022-11-10 updated component placement
    [vario.kicad_pcb]
2022-11-11 some routing done
    [vario.kicad_pcb]
2022-11-11 updated todos in readme and put some more component placements
    [vario.kicad_pcb, vario.kicad_sch]
2022-11-13 changed from 3V3 to 3.3VA on the I2C connectors.
    [vario.kicad_pcb, vario.kicad_sch]
2022-11-13 removed usart6 connections in order to save layout room
    [vario.kicad_pcb, vario.kicad_sch]
2022-11-13 more rooting done...
    [vario.kicad_pcb, vario.kicad_sch]
2022-11-14 routing extended...
    [vario.kicad_pcb]
2022-11-19 moved connectors to overhang the PCB a bit
    [vario.kicad_pcb]
2022-11-19 connected interfaces to analog section
    [vario.kicad_pcb]
2022-11-19 minor changes
    [vario.kicad_pcb, vario.kicad_sch]
2022-11-19 more rooting done
    [vario.kicad_pcb, vario.kicad_sch]
2022-11-19 connected reset, program button switches and usb connectors
    [vario.kicad_pcb, vario.kicad_sch]
2022-11-20 added booster for usb voltage
    [vario.kicad_sch]
2022-11-20 added symbol in schematic for preassure hood, changed the inductor to a more reasonabile sized one
    [vario.kicad_pcb, vario.kicad_sch]
2022-11-20 added a lot of silkscreen text
    [vario.kicad_pcb, vario.kicad_sch]
2022-11-21 added esd tvs for gnss antenna, and ferrits for schield to gnd connection
    [vario.kicad_pcb, vario.kicad_sch]
2022-11-22 added led control to 3.3VA supply, added tvs for voltage supply, updated ptc fuse
    [vario.kicad_pcb, vario.kicad_sch]
2022-11-22 intermediate version
    [vario.kicad_pcb, vario.kicad_sch]
2022-11-23 added GNSS antenna LNA current limiting circuit
    [vario.kicad_sch]
2022-11-23 resolved some DRC errors in layout and schematic
    [vario.kicad_pcb, vario.kicad_sch]
2022-11-23 added some copper fillings and completed buck layout
    [vario.kicad_pcb]
2022-11-24 added filled zones and keepout areas
    [vario.kicad_pcb, vario.kicad_sch]
2022-11-24 fixed warnings
    [vario.kicad_pcb]
2022-11-24 fixed DRC errors
    [vario.kicad_pcb, vario.kicad_sch]
2022-11-24 more copper planes, GND shield finalized und TODO list updated
    [vario.kicad_pcb, vario.kicad_sch]
2022-11-24 put some vias
    [vario.kicad_pcb, vario.kicad_sch]
2022-11-24 silkscreen beautification
    [vario.kicad_pcb]
2022-11-24 some more silkscreen changes
    [vario.kicad_pcb]
2022-11-30 adjusted some review findings
    [vario.kicad_pcb, vario.kicad_sch]
2022-11-30 added cuts in filled areas around the dc dc converters
    [vario.kicad_pcb, vario.kicad_sch]
2022-11-30 almost done with the layout
    [vario.kicad_pcb]
2022-12-01 schematic: cleanup and minor changes layout: cooling copper for LDO
    [vario.kicad_pcb, vario.kicad_sch]
2022-12-03 updated markdown documents
    [vario.kicad_pcb, vario.kicad_sch]
2022-12-03 added an esp32 status led
    [vario.kicad_pcb, vario.kicad_sch]
2022-12-03 added coordinate silkscreen symbol
    [vario.kicad_pcb]
2022-12-03 added order number location, generated production files
    [vario-B_Cu.gbr, vario-B_Mask.gbr, vario-B_Paste.gbr, vario-B_SilkS.gbr, vario-Edge_Cuts.gbr, vario-F_Cu.gbr, vario-F_Mask.gbr, vario-F_Paste.gbr]
2022-12-03 changed esp32 part number to the 8MB version as the 16MB version requires a different assembly process
    [vario.kicad_sch]
2022-12-03 updated production files
    [vario.csv]
2022-12-03 added smd assembly tooling holes for jlcpcb process
    [vario.kicad_pcb, vario.kicad_sch]
2022-12-04 added a last CAN header, a feedthrough capacitors and moved imu routing to layer 1
    [vario.kicad_pcb, vario.kicad_sch]
2022-12-04 finalized schematic and layout
    [vario.kicad_pcb, vario.kicad_sch]
2022-12-04 generated production files
    [vario.csv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]
2022-12-04 added some more GND vias to ldo cooling cooper plane, updated production files
    [vario.kicad_pcb, vario.kicad_sch]
2022-12-04 adapted position file header
    [vario-top-pos.csv]
2022-12-04 added V2.0 schematic pdf
    [vario.kicad_sch]
2022-12-04 added missing coordinate symbol, moved IMU resistors a bit away from the footprint for solderability
    [vario.kicad_pcb, vario.kicad_sch]
2022-12-05 updated readme with required parts besides pcb
2022-12-07 started cleaning up BOM
    [vario.kicad_sch]
2022-12-07 added missing part number
    [vario.kicad_sch]
2022-12-07 globally cleaned up schematic symbol fields
    [vario.kicad_sch]
2022-12-07 corrected missing order number in BOM
    [vario.csv]
2022-12-16 cleanup of BOM and added some Manufacturing Part Numbers
    [vario.kicad_sch]
2022-12-16 added v2 pcb picture to first readme page
2023-03-21 added assembly pictures v2 hw
2023-03-22 added cover plate pcbs
    [PreassurePart.FCStd]
2023-07-30 updated project for KiCAD version 7
    [vario.kicad_pcb, vario.kicad_sch]
2024-01-06 Added information from #11 to schematic
    [vario.kicad_sch]
2024-01-06 incremented version to 2.1. and fixed the usb-c smd - throughhole drc errors
    [vario.kicad_pcb]
2024-01-06 added uart GPS solder jumpers to schematic
    [vario.kicad_sch]
2024-01-06 added solder jumpers in front of the GNSS M9N UART RX/TX connection. #10
    [vario.kicad_pcb, vario.kicad_sch]
2024-01-06 switched DGNSS pixhawk connector pins. Fixed #2
    [vario.kicad_pcb, vario.kicad_sch]
2024-01-06 corrected silkscreen labels
    [vario.kicad_pcb]
2024-01-06 added keep out areas below potential cut lines (closed solder jumpers) to reduce short circuit risks. Added solder jumper to optionally switch to the old can pinout configuration #4
    [vario.kicad_pcb, vario.kicad_sch]
2024-03-10 added 2.54 mm jumper for CAN Termination. #12
    [vario.kicad_pcb, vario.kicad_sch]
2024-06-01 added freecad and stl file of pressure hood. fixes #15
    [hood.FCStd, hood.stl]
2025-02-21 fixed #19 and moved RJ45 connectors towards each other
    [vario.kicad_pcb, vario.kicad_sch]
2025-02-23 fix #16 add a CAN termination switch below the pressure hood
    [vario.kicad_pcb, vario.kicad_sch]
2025-02-23 fix #20 some more space around imu module
    [vario.kicad_pcb]
2025-02-23 updated layout modification date
    [vario.kicad_pcb]
2025-02-24 added tvs diodes for sdio interface fíx #23
    [vario.kicad_pcb, vario.kicad_sch]
2025-02-24 remove production data from repo as this will be added as a release binary
    [vario.csv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]
2025-12-30 migrated kicad project files to kicad version 9
    [vario.kicad_pcb, vario.kicad_sch]
